ZS6SR/TimeBuddy/docs/photos/WhatsApp Image 2026-10-26 at 08.11.50.jpeg

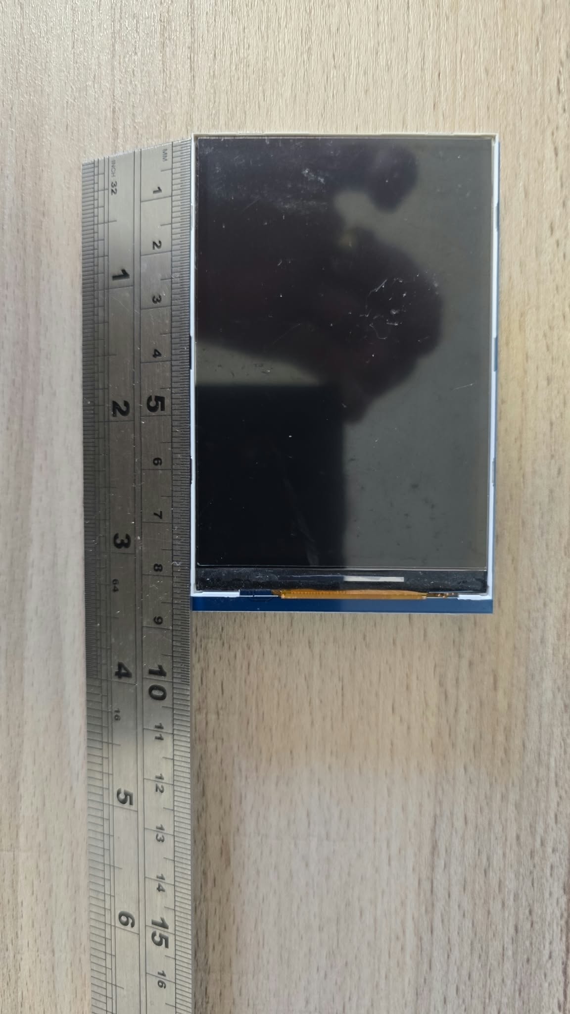
docs/photos/WhatsApp Image 2026-10-26 at 08.11.50.jpeg
