ZS6SR/TimeBuddy/case/timebuddy_stand.stl

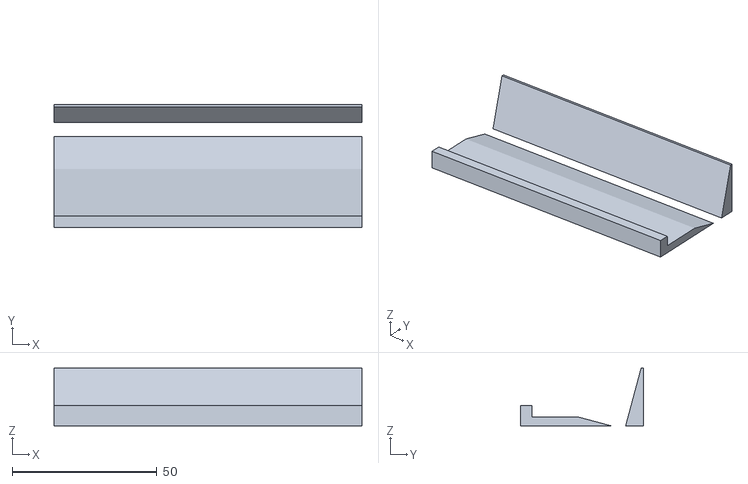
[picture p9: CAD file, 2026-10-26]
case/timebuddy_stand.stl
106.5 x 42.6 x 20.0
