ZS6SR/TimeBuddy/case/timebuddy_frame.stl

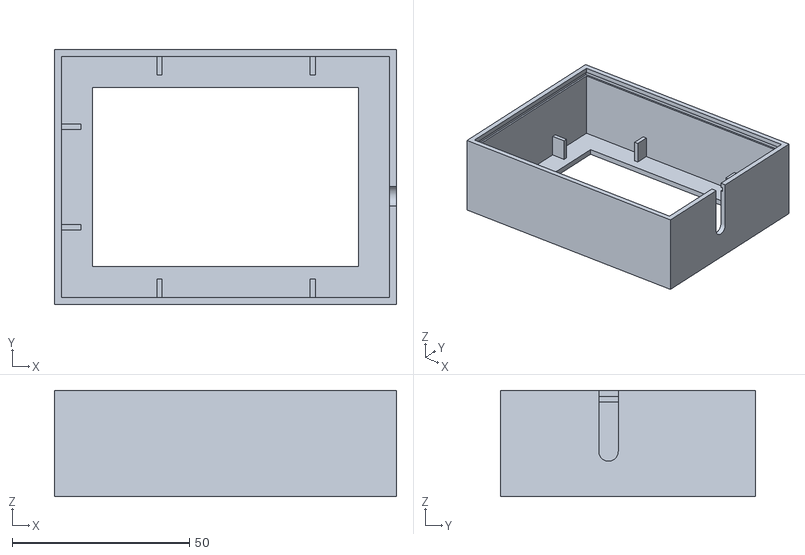
[picture p10: CAD file, 2026-10-26]
case/timebuddy_frame.stl
96.5 x 72.0 x 30.0
