ZS6SR/TimeBuddy/case/timebuddy_back.stl

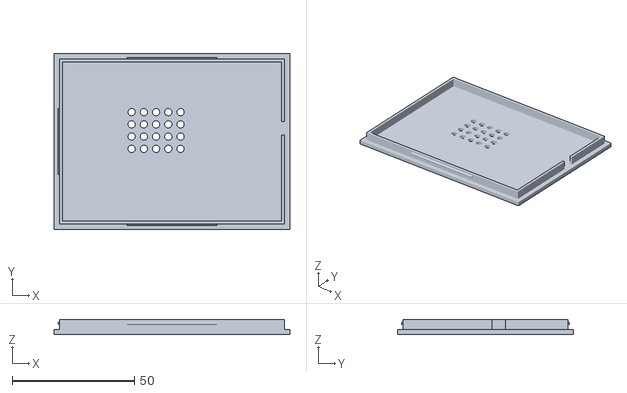
[picture p11: CAD file, 2026-10-26]
case/timebuddy_back.stl
96.5 x 72.0 x 6.00
