ZS6SR/TimeBuddy/firmware/src/main.cpp

#include <Arduino.h>
#include <ArduinoJson.h>
#include <Arduino_GFX_Library.h>
#include <DNSServer.h>
#include <ESPmDNS.h>
#include <HTTPClient.h>
#include <Preferences.h>
#include <WebServer.h>
#include <WiFi.h>
#include <WiFiClientSecure.h>
#include <Update.h>
#include <time.h>

#include "config.h"
#include "secrets.h"
#include "tracks.h"
#include "web.h"
#include "fonts/FreeSans9pt7b.h"
#include "fonts/FreeSans12pt7b.h"
#include "fonts/FreeSans16pt7b.h"
#include "fonts/FreeSansBoldOblique12pt7b.h"

static const int PAD = 14;

static const uint16_t COL_BG = RGB565(10, 14, 24);
static const uint16_t COL_TEXT = RGB565(235, 240, 248);
static const uint16_t COL_NAME = RGB565(120, 180, 255);
static const uint16_t COL_DIM = RGB565(140, 155, 180);
static const uint16_t COL_TEMP = RGB565(255, 190, 90);
static const uint16_t COL_LINE = RGB565(45, 55, 75);
static const uint16_t COL_BORDER = RGB565(70, 85, 110);
static const uint16_t COL_RACE = RGB565(230, 40, 40);
static const uint16_t COL_SUN = RGB565(255, 200, 40);
static const uint16_t COL_MOON = RGB565(220, 225, 240);
static const uint16_t COL_CLOUD = RGB565(200, 208, 220);
static const uint16_t COL_DARK_CLOUD = RGB565(120, 130, 150);
static const uint16_t COL_RAIN = RGB565(80, 160, 255);
static const uint16_t COL_SNOW = RGB565(255, 255, 255);

Arduino_DataBus *bus = new Arduino_SWPAR8(
    PIN_RS, GFX_NOT_DEFINED, PIN_WR, GFX_NOT_DEFINED,
    PIN_D0, PIN_D1, PIN_D2, PIN_D3, PIN_D4, PIN_D5, PIN_D6, PIN_D7);

#if DISPLAY_ST7796
Arduino_GFX *gfx = new Arduino_ST7796(bus, PIN_RST, PORTRAIT_ROTATION);
#else
Arduino_GFX *gfx = new Arduino_ILI9486(bus, PIN_RST, PORTRAIT_ROTATION);
#endif

Arduino_Canvas *canvas = nullptr;
Preferences prefs;
WebServer server(80);
DNSServer dns;

struct Layout {
  int title, date, icon, temp;
};
static const Layout PORTRAIT_LAYOUT = {50, 76, 110, 124};
static const Layout LANDSCAPE_LAYOUT = {38, 58, 76, 90};
static const int ROWS_PERCENT_LANDSCAPE = 40;

static bool landscape = false;
static int scrW, scrH, rowW, rowStep;
static const Layout *layout = &PORTRAIT_LAYOUT;

struct Weather {
  bool valid = false;
  float temp = 0;
  int code = -1;
  bool isDay = true;
};

enum Icon { ICON_NONE, ICON_CLEAR, ICON_PARTLY, ICON_CLOUDY, ICON_FOG, ICON_RAIN, ICON_SNOW, ICON_THUNDER };

static Weather weather[3];
struct Race {
  time_t weekendStart = 0;
  time_t start = 0;
  char place[48] = "";
  float lat = 0;
  float lon = 0;
  Weather forecast;
  const Track *track = nullptr;
};

static Race motogp;
static Race f1;

struct PaneType {
  const char *id;
  const char *title;
  const Race *race;
};

static const PaneType PANE_TYPES[] = {
    {"motogp", "MotoGP", &motogp},
    {"f1", "F1", &f1},
};
static const int PANE_TYPE_COUNT = sizeof(PANE_TYPES) / sizeof(PANE_TYPES[0]);

struct Place {
  char name[32];
  char country[32];
  char zone[48];
  char tz[64];
  float lat;
  float lon;
};

static Place places[3];
static int panes[2] = {0, 1};
static bool configChanged = false;

struct NetSettings {
  char ssid[33];
  char password[65];
  bool dhcp;
  char ip[16];
  char gateway[16];
  char subnet[16];
  char dns[16];
};

static NetSettings net;
static bool setupMode = false;
static unsigned long lastWebActivity = 0;
static unsigned long restartAt = 0;
static unsigned long lastMotoGPFetch = 0;
static unsigned long lastF1Fetch = 0;
static bool motogpFetched = false;
static bool f1Fetched = false;
static unsigned long lastWeatherFetch = 0;
static bool weatherEverFetched = false;
static int lastMinute = -1;
static bool lastButton = true;

static Icon iconFor(int code) {
  switch (code) {
    case 0: case 1: return ICON_CLEAR;
    case 2: return ICON_PARTLY;
    case 3: return ICON_CLOUDY;
    case 45: case 48: return ICON_FOG;
    case 51: case 53: case 55: case 56: case 57:
    case 61: case 63: case 65: case 66: case 67:
    case 80: case 81: case 82: return ICON_RAIN;
    case 71: case 73: case 75: case 77: case 85: case 86: return ICON_SNOW;
    case 95: case 96: case 99: return ICON_THUNDER;
    default: return ICON_NONE;
  }
}

static const float ICON_SCALE = 0.75f;
static Arduino_GFX *ink = nullptr;

static int sc(float v) {
  return lroundf(v * ICON_SCALE);
}

static void drawSun(int cx, int cy, float r) {
  for (int a = 0; a < 360; a += 45) {
    float rad = a * DEG_TO_RAD;
    int x0 = cx + cosf(rad) * sc(r + 4), y0 = cy + sinf(rad) * sc(r + 4);
    int x1 = cx + cosf(rad) * sc(r + 8), y1 = cy + sinf(rad) * sc(r + 8);
    ink->drawLine(x0, y0, x1, y1, COL_SUN);
    ink->drawLine(x0 + 1, y0, x1 + 1, y1, COL_SUN);
  }
  ink->fillCircle(cx, cy, sc(r), COL_SUN);
}

static void drawMoon(int cx, int cy, float r) {
  ink->fillCircle(cx, cy, sc(r), COL_MOON);
  ink->fillCircle(cx + sc(r / 2 + 2), cy - sc(r / 3), sc(r - 1), COL_BG);
}

static void drawCloud(int cx, int cy, uint16_t colour) {
  ink->fillCircle(cx - sc(10), cy + sc(2), sc(8), colour);
  ink->fillCircle(cx + sc(1), cy - sc(5), sc(11), colour);
  ink->fillCircle(cx + sc(11), cy + sc(2), sc(8), colour);
  ink->fillRoundRect(cx - sc(18), cy + sc(1), sc(37), sc(10), sc(5), colour);
}

static void drawIcon(Icon icon, bool isDay, int cx, int cy) {
  switch (icon) {
    case ICON_CLEAR:
      if (isDay) drawSun(cx, cy, 10);
      else drawMoon(cx, cy, 13);
      break;
    case ICON_PARTLY:
      if (isDay) drawSun(cx + sc(8), cy - sc(8), 8);
      else drawMoon(cx + sc(8), cy - sc(8), 10);
      drawCloud(cx - sc(3), cy + sc(5), COL_CLOUD);
      break;
    case ICON_CLOUDY:
      drawCloud(cx, cy, COL_CLOUD);
      break;
    case ICON_FOG:
      for (int i = 0; i < 4; i++) {
        int w = sc((i % 2) ? 30 : 38);
        ink->fillRoundRect(cx - w / 2, cy - sc(12) + i * sc(8), w, sc(4), sc(2), COL_CLOUD);
      }
      break;
    case ICON_RAIN:
      drawCloud(cx, cy - sc(6), COL_CLOUD);
      for (int i = -1; i <= 1; i++) {
        int x = cx + i * sc(10);
        ink->drawLine(x + sc(2), cy + sc(9), x - sc(2), cy + sc(17), COL_RAIN);
        ink->drawLine(x + sc(2) + 1, cy + sc(9), x - sc(2) + 1, cy + sc(17), COL_RAIN);
      }
      break;
    case ICON_SNOW:
      drawCloud(cx, cy - sc(6), COL_CLOUD);
      for (int i = -1; i <= 1; i++) {
        int x = cx + i * sc(10);
        ink->fillCircle(x, cy + sc(12), 2, COL_SNOW);
        ink->fillCircle(x + sc(5), cy + sc(18), 2, COL_SNOW);
      }
      break;
    case ICON_THUNDER:
      drawCloud(cx, cy - sc(6), COL_DARK_CLOUD);
      ink->fillTriangle(cx + sc(2), cy + sc(4), cx - sc(6), cy + sc(14), cx + sc(1), cy + sc(14), COL_SUN);
      ink->fillTriangle(cx - sc(1), cy + sc(12), cx + sc(6), cy + sc(12), cx - sc(3), cy + sc(22), COL_SUN);
      break;
    default:
      break;
  }
}

static void printAt(const GFXfont *font, const char *text, int x, int y, uint16_t colour, bool alignRight) {
  int16_t x1, y1;
  uint16_t w, h;
  canvas->setFont(font);
  canvas->setTextColor(colour);
  canvas->getTextBounds(text, 0, y, &x1, &y1, &w, &h);
  canvas->setCursor(alignRight ? x - (int)w - x1 : x - x1, y);
  canvas->print(text);
}

static void drawWeather(Arduino_GFX *g, const Weather &w, int x, int iconY, int tempY) {
  ink = g;
  drawIcon(iconFor(w.code), w.isDay, x + 16, iconY);

  char buf[16];
  snprintf(buf, sizeof(buf), "%d", (int)lroundf(w.temp));
  int16_t x1, y1;
  uint16_t tw, th;
  int tx = x + 38;
  g->setFont(&FreeSans12pt7b);
  g->getTextBounds(buf, 0, tempY, &x1, &y1, &tw, &th);
  g->setTextColor(COL_TEMP);
  g->setCursor(tx - x1, tempY);
  g->print(buf);
  int dx = tx + tw + 5;
  g->drawCircle(dx, y1 + 3, 2, COL_TEMP);
  g->setFont(&FreeSans9pt7b);
  g->setCursor(dx + 4, y1 + 13);
  g->print("C");
}

static void showStatus(const char *line1, const char *line2, const char *line3 = nullptr) {
  gfx->fillScreen(COL_BG);
  gfx->setFont(&FreeSans12pt7b);
  gfx->setTextColor(COL_TEXT);
  gfx->setCursor(30, 140);
  gfx->print(line1);
  gfx->setFont(&FreeSans9pt7b);
  gfx->setTextColor(COL_DIM);
  gfx->setCursor(30, 175);
  gfx->print(line2);
  if (line3) {
    gfx->setCursor(30, 200);
    gfx->print(line3);
  }
}

static void localTimeFor(const Place &loc, time_t now, struct tm *out);

static void raceWhen(const Race &race, char *when, size_t size) {
  snprintf(when, size, "--");
  if (race.start) {
    const Place &loc = places[RACE_TIME_LOCATION];
    struct tm from, to;
    localTimeFor(loc, race.weekendStart ? race.weekendStart : race.start, &from);
    localTimeFor(loc, race.start, &to);
    char a[16], b[24];
    strftime(a, sizeof(a), from.tm_mon == to.tm_mon ? "%d" : "%d %b", &from);
    strftime(b, sizeof(b), "%d %b %H:%M", &to);
    snprintf(when, size, "%s - %s", a, b);
  }
}

static void drawBlock(int x, int y, int w, int h, const PaneType &type) {
  const Race &race = *type.race;
  gfx->drawRoundRect(x, y, w, h, 6, COL_BORDER);
  gfx->setFont(&FreeSansBoldOblique12pt7b);
  gfx->setTextColor(COL_RACE);
  gfx->setCursor(x + 10, y + 26);
  gfx->print(type.title);
  if (race.track) {
    gfx->drawBitmap(x + w - 10 - TRACK_W, y + 8, race.track->bits, TRACK_W, TRACK_H, COL_TEXT);
  }

  char when[48];
  raceWhen(race, when, sizeof(when));
  if (race.forecast.valid) {
    drawWeather(gfx, race.forecast, x + 10, y + h - 74, y + h - 64);
  }
  gfx->setFont(&FreeSans12pt7b);
  gfx->setTextColor(COL_TEXT);
  gfx->setCursor(x + 10, y + h - 36);
  gfx->print(race.place);
  gfx->setFont(&FreeSans9pt7b);
  gfx->setTextColor(COL_DIM);
  gfx->setCursor(x + 10, y + h - 14);
  gfx->print(when);
}

static void drawPane() {
  if (rowW < scrW) {
    const int gap = 8;
    int x = rowW + gap;
    int w = scrW - x - gap;
    int h = (scrH - 3 * gap) / 2;
    gfx->fillRect(rowW, 0, scrW - rowW, scrH, COL_BG);
    drawBlock(x, gap, w, h, PANE_TYPES[panes[0]]);
    drawBlock(x, 2 * gap + h, w, h, PANE_TYPES[panes[1]]);
  }
}

static void applyOrientation() {
  gfx->setRotation(landscape ? LANDSCAPE_ROTATION : PORTRAIT_ROTATION);
  scrW = gfx->width();
  scrH = gfx->height();
  rowW = landscape ? scrW * ROWS_PERCENT_LANDSCAPE / 100 : scrW;
  rowStep = scrH / 3;
  layout = landscape ? &LANDSCAPE_LAYOUT : &PORTRAIT_LAYOUT;

  delete canvas;
  canvas = new Arduino_Canvas(rowW, scrH - 2 * rowStep, gfx);
  canvas->begin(GFX_SKIP_OUTPUT_BEGIN);
  gfx->fillScreen(COL_BG);
  drawPane();
}

static void localTimeFor(const Place &loc, time_t now, struct tm *out) {
  setenv("TZ", loc.tz, 1);
  tzset();
  localtime_r(&now, out);
}

static void drawRow(int i, time_t now) {
  const Place &loc = places[i];
  struct tm t;
  localTimeFor(loc, now, &t);

  canvas->fillScreen(COL_BG);
  if (i > 0) {
    canvas->drawFastHLine(PAD, 0, rowW - 2 * PAD, COL_LINE);
  }

  printAt(&FreeSans12pt7b, loc.name, PAD, layout->title, COL_NAME, false);

  char buf[32];
  strftime(buf, sizeof(buf), "%H:%M", &t);
  printAt(&FreeSans16pt7b, buf, rowW - PAD, layout->title, COL_TEXT, true);
  strftime(buf, sizeof(buf), "%a %d %b", &t);
  printAt(&FreeSans9pt7b, buf, rowW - PAD, layout->date, COL_DIM, true);

  const Weather &w = weather[i];
  if (w.valid) {
    drawWeather(canvas, w, PAD, layout->icon, layout->temp);
  } else {
    printAt(&FreeSans12pt7b, "--", PAD, layout->temp, COL_DIM, false);
  }

  int y = i * rowStep;
  int h = (i == 2) ? scrH - y : rowStep;
  gfx->draw16bitRGBBitmap(0, y, canvas->getFramebuffer(), rowW, h);
}

static void drawAll() {
  time_t now = time(nullptr);
  for (int i = 0; i < 3; i++) {
    drawRow(i, now);
  }
}

static bool fetchWeather() {
  String url = "https://api.open-meteo.com/v1/forecast?current=temperature_2m,weather_code,is_day&latitude=";
  for (int i = 0; i < 3; i++) {
    if (i) url += ",";
    url += String(places[i].lat, 4);
  }
  url += "&longitude=";
  for (int i = 0; i < 3; i++) {
    if (i) url += ",";
    url += String(places[i].lon, 4);
  }

  WiFiClientSecure client;
  client.setInsecure();
  HTTPClient http;
  http.setTimeout(10000);
  http.useHTTP10(true);
  if (!http.begin(client, url)) {
    Serial.println("Weather begin failed");
    return false;
  }
  int status = http.GET();
  if (status != HTTP_CODE_OK) {
    Serial.printf("Weather HTTP %d\n", status);
    http.end();
    return false;
  }

  JsonDocument filter;
  filter[0]["current"]["temperature_2m"] = true;
  filter[0]["current"]["weather_code"] = true;
  filter[0]["current"]["is_day"] = true;
  JsonDocument doc;
  DeserializationError err = deserializeJson(doc, http.getStream(), DeserializationOption::Filter(filter));
  http.end();
  if (err) {
    Serial.printf("Weather JSON: %s\n", err.c_str());
    return false;
  }

  JsonArray arr = doc.as<JsonArray>();
  for (int i = 0; i < 3 && i < (int)arr.size(); i++) {
    JsonObject cur = arr[i]["current"];
    if (cur["temperature_2m"].is<float>()) {
      weather[i].temp = cur["temperature_2m"].as<float>();
      weather[i].code = cur["weather_code"] | -1;
      weather[i].isDay = (cur["is_day"] | 1) == 1;
      weather[i].valid = true;
    }
  }
  return true;
}

class BlockingStream : public Stream {
 public:
  BlockingStream(WiFiClientSecure &client, unsigned long timeout) : client_(client), timeout_(timeout) {}
  int available() override { return client_.available(); }
  int read() override { return wait() ? client_.read() : -1; }
  int peek() override { return wait() ? client_.peek() : -1; }
  size_t write(uint8_t) override { return 0; }

 private:
  bool wait() {
    unsigned long start = millis();
    while (!client_.available()) {
      if (!client_.connected() || millis() - start > timeout_) return false;
      delay(1);
    }
    return true;
  }
  WiFiClientSecure &client_;
  unsigned long timeout_;
};

static int64_t daysFromCivil(int y, int m, int d) {
  y -= m <= 2;
  int era = (y >= 0 ? y : y - 399) / 400;
  int yoe = y - era * 400;
  int doy = (153 * (m + (m > 2 ? -3 : 9)) + 2) / 5 + d - 1;
  int doe = yoe * 365 + yoe / 4 - yoe / 100 + doy;
  return (int64_t)era * 146097 + doe - 719468;
}

static time_t parseIso(const char *s) {
  int Y, M, D, h, mi, sec;
  int n = 0;
  if (sscanf(s, "%d-%d-%dT%d:%d:%d%n", &Y, &M, &D, &h, &mi, &sec, &n) < 6) return 0;
  const char *tz = s + n;
  long offset = 0;
  if (*tz == '+' || *tz == '-') {
    int sign = (*tz == '-') ? -1 : 1;
    int digits[4] = {0, 0, 0, 0};
    int k = 0;
    for (const char *c = tz + 1; *c && k < 4; c++) {
      if (isdigit((unsigned char)*c)) digits[k++] = *c - '0';
    }
    offset = sign * ((digits[0] * 10 + digits[1]) * 3600L + (digits[2] * 10 + digits[3]) * 60L);
  }
  return (time_t)(daysFromCivil(Y, M, D) * 86400 + h * 3600L + mi * 60L + sec - offset);
}

static bool fetchF1(Race &out) {
  WiFiClientSecure client;
  client.setInsecure();
  HTTPClient http;
  http.setTimeout(10000);
  http.useHTTP10(true);
  if (!http.begin(client, "https://api.jolpi.ca/ergast/f1/current/next.json")) return false;
  int status = http.GET();
  if (status != HTTP_CODE_OK) {
    Serial.printf("F1 HTTP %d\n", status);
    http.end();
    return false;
  }
  JsonDocument filter;
  JsonObject f = filter["MRData"]["RaceTable"]["Races"][0].to<JsonObject>();
  f["date"] = true;
  f["time"] = true;
  f["FirstPractice"]["date"] = true;
  f["FirstPractice"]["time"] = true;
  f["Circuit"]["Location"]["locality"] = true;
  f["Circuit"]["Location"]["country"] = true;
  f["Circuit"]["Location"]["lat"] = true;
  f["Circuit"]["Location"]["long"] = true;
  JsonDocument doc;
  BlockingStream stream(client, 10000);
  DeserializationError err = deserializeJson(doc, stream, DeserializationOption::Filter(filter));
  http.end();
  if (err) {
    Serial.printf("F1 JSON: %s\n", err.c_str());
    return false;
  }
  JsonObject race = doc["MRData"]["RaceTable"]["Races"][0];
  if (race.isNull()) return false;
  String iso = String(race["date"] | "") + "T" + (race["time"] | "00:00:00Z");
  out.start = parseIso(iso.c_str());
  iso = String(race["FirstPractice"]["date"] | "") + "T" + (race["FirstPractice"]["time"] | "00:00:00Z");
  out.weekendStart = parseIso(iso.c_str());
  snprintf(out.place, sizeof(out.place), "%s, %s", (const char *)(race["Circuit"]["Location"]["locality"] | ""),
           (const char *)(race["Circuit"]["Location"]["country"] | ""));
  out.lat = atof(race["Circuit"]["Location"]["lat"] | "0");
  out.lon = atof(race["Circuit"]["Location"]["long"] | "0");
  return out.start != 0;
}

static bool fetchMotoGP(int year, Race &out) {
  WiFiClientSecure client;
  client.setInsecure();
  HTTPClient http;
  http.setTimeout(15000);
  http.useHTTP10(true);
  String url = String("https://api.motogp.pulselive.com/motogp/v1/events?seasonYear=") + year;
  if (!http.begin(client, url)) return false;
  int status = http.GET();
  if (status != HTTP_CODE_OK) {
    Serial.printf("MotoGP HTTP %d\n", status);
    http.end();
    return false;
  }
  JsonDocument filter;
  filter["date_start"] = true;
  filter["circuit"]["city"] = true;
  filter["circuit"]["country"] = true;
  filter["circuit"]["lat"] = true;
  filter["circuit"]["lng"] = true;
  filter["broadcasts"][0]["shortname"] = true;
  filter["broadcasts"][0]["category"]["acronym"] = true;
  filter["broadcasts"][0]["date_start"] = true;

  BlockingStream stream(client, 15000);
  time_t now = time(nullptr);
  bool found = false;
  bool more = stream.find("[");
  while (more) {
    JsonDocument doc;
    DeserializationError err = deserializeJson(doc, stream, DeserializationOption::Filter(filter));
    if (err) {
      Serial.printf("MotoGP JSON: %s\n", err.c_str());
      break;
    }
    for (JsonObject b : doc["broadcasts"].as<JsonArray>()) {
      if (strcmp(b["shortname"] | "", "RAC") == 0 && strcmp(b["category"]["acronym"] | "", "MGP") == 0) {
        time_t t = parseIso(b["date_start"] | "");
        if (t > now && (!found || t < out.start)) {
          found = true;
          out.start = t;
          out.weekendStart = parseIso(doc["date_start"] | "");
          snprintf(out.place, sizeof(out.place), "%s, %s", (const char *)(doc["circuit"]["city"] | ""),
                   (const char *)(doc["circuit"]["country"] | ""));
          out.lat = atof(doc["circuit"]["lat"] | "0");
          out.lon = atof(doc["circuit"]["lng"] | "0");
        }
      }
    }
    more = stream.findUntil(",", "]");
  }
  http.end();
  return found;
}

static const Track *findTrack(float lat, float lon) {
  const Track *best = nullptr;
  float bestKm = 30;
  for (const Track &t : TRACKS) {
    float dx = (t.lon - lon) * cosf(lat * DEG_TO_RAD) * 111.32f;
    float dy = (t.lat - lat) * 110.57f;
    float km = sqrtf(dx * dx + dy * dy);
    if (km < bestKm) {
      bestKm = km;
      best = &t;
    }
  }
  return best;
}

static void fetchRaceForecast(Race &race) {
  race.forecast.valid = false;
  if (!race.start || race.start - time(nullptr) > 15L * 24 * 3600) return;
  struct tm t;
  gmtime_r(&race.start, &t);
  char hour[20];
  strftime(hour, sizeof(hour), "%Y-%m-%dT%H:00", &t);
  String url = "https://api.open-meteo.com/v1/forecast?hourly=temperature_2m,weather_code,is_day";
  url += "&latitude=" + String(race.lat, 4) + "&longitude=" + String(race.lon, 4);
  url += String("&start_hour=") + hour + "&end_hour=" + hour;

  WiFiClientSecure client;
  client.setInsecure();
  HTTPClient http;
  http.setTimeout(10000);
  http.useHTTP10(true);
  if (!http.begin(client, url)) return;
  int status = http.GET();
  if (status != HTTP_CODE_OK) {
    http.end();
    return;
  }
  JsonDocument doc;
  BlockingStream stream(client, 10000);
  DeserializationError err = deserializeJson(doc, stream);
  http.end();
  if (err || !doc["hourly"]["temperature_2m"][0].is<float>()) return;
  race.forecast.temp = doc["hourly"]["temperature_2m"][0];
  race.forecast.code = doc["hourly"]["weather_code"][0] | -1;
  race.forecast.isDay = (doc["hourly"]["is_day"][0] | 1) == 1;
  race.forecast.valid = true;
}

static bool fetchMotoGPRace() {
  time_t now = time(nullptr);
  struct tm t;
  gmtime_r(&now, &t);
  for (int attempt = 0; attempt < 2; attempt++) {
    Race r;
    if (fetchMotoGP(t.tm_year + 1900, r) || fetchMotoGP(t.tm_year + 1901, r)) {
      fetchRaceForecast(r);
      r.track = findTrack(r.lat, r.lon);
      motogp = r;
      return true;
    }
  }
  return false;
}

static bool fetchF1Race() {
  for (int attempt = 0; attempt < 2; attempt++) {
    Race r;
    if (fetchF1(r)) {
      fetchRaceForecast(r);
      r.track = findTrack(r.lat, r.lon);
      f1 = r;
      return true;
    }
  }
  return false;
}

static void loadDefaults() {
  for (int i = 0; i < 3; i++) {
    Place &p = places[i];
    strlcpy(p.name, LOCATIONS[i].name, sizeof(p.name));
    strlcpy(p.country, LOCATIONS[i].country, sizeof(p.country));
    p.zone[0] = '\0';
    strlcpy(p.tz, LOCATIONS[i].posixTz, sizeof(p.tz));
    p.lat = LOCATIONS[i].lat;
    p.lon = LOCATIONS[i].lon;
  }
  panes[0] = 0;
  panes[1] = 1;
}

static int paneIndex(const char *id) {
  for (int i = 0; i < PANE_TYPE_COUNT; i++) {
    if (strcmp(PANE_TYPES[i].id, id) == 0) return i;
  }
  return -1;
}

static bool applyConfig(JsonObjectConst cfg) {
  JsonArrayConst locs = cfg["locations"];
  JsonArrayConst ids = cfg["panes"];
  if (locs.size() != 3 || ids.size() != 2) return false;

  Place next[3];
  for (int i = 0; i < 3; i++) {
    JsonObjectConst l = locs[i];
    const char *tz = l["tz"] | "";
    if (!*tz || !l["lat"].is<float>() || !l["lon"].is<float>()) return false;
    strlcpy(next[i].name, l["name"] | "", sizeof(next[i].name));
    strlcpy(next[i].country, l["country"] | "", sizeof(next[i].country));
    strlcpy(next[i].zone, l["zone"] | "", sizeof(next[i].zone));
    strlcpy(next[i].tz, tz, sizeof(next[i].tz));
    next[i].lat = l["lat"];
    next[i].lon = l["lon"];
  }
  int nextPanes[2];
  for (int i = 0; i < 2; i++) {
    nextPanes[i] = paneIndex(ids[i] | "");
    if (nextPanes[i] < 0) return false;
  }

  memcpy(places, next, sizeof(places));
  memcpy(panes, nextPanes, sizeof(panes));
  return true;
}

static void configToJson(JsonObject cfg) {
  JsonArray locs = cfg["locations"].to<JsonArray>();
  for (const Place &p : places) {
    JsonObject l = locs.add<JsonObject>();
    l["name"] = p.name;
    l["country"] = p.country;
    l["zone"] = p.zone;
    l["tz"] = p.tz;
    l["lat"] = p.lat;
    l["lon"] = p.lon;
  }
  JsonArray ids = cfg["panes"].to<JsonArray>();
  for (int p : panes) {
    ids.add(PANE_TYPES[p].id);
  }
}

static void loadConfig() {
  loadDefaults();
  if (!prefs.isKey("config")) return;
  String saved = prefs.getString("config", "");
  JsonDocument doc;
  if (deserializeJson(doc, saved) || !applyConfig(doc.as<JsonObjectConst>())) {
    Serial.println("Saved config invalid, using defaults");
    loadDefaults();
  }
}

static void saveConfig() {
  JsonDocument doc;
  configToJson(doc.to<JsonObject>());
  String out;
  serializeJson(doc, out);
  prefs.putString("config", out);
}

static void loadNetwork() {
  strlcpy(net.ssid, WIFI_SSID, sizeof(net.ssid));
  strlcpy(net.password, WIFI_PASSWORD, sizeof(net.password));
  net.dhcp = true;
  net.ip[0] = net.gateway[0] = net.subnet[0] = net.dns[0] = '\0';

  if (!prefs.isKey("network")) return;
  String saved = prefs.getString("network", "");
  JsonDocument doc;
  if (deserializeJson(doc, saved)) return;
  strlcpy(net.ssid, doc["ssid"] | net.ssid, sizeof(net.ssid));
  strlcpy(net.password, doc["password"] | net.password, sizeof(net.password));
  net.dhcp = doc["dhcp"] | true;
  strlcpy(net.ip, doc["ip"] | "", sizeof(net.ip));
  strlcpy(net.gateway, doc["gateway"] | "", sizeof(net.gateway));
  strlcpy(net.subnet, doc["subnet"] | "", sizeof(net.subnet));
  strlcpy(net.dns, doc["dns"] | "", sizeof(net.dns));
}

static void saveNetwork() {
  JsonDocument doc;
  doc["ssid"] = net.ssid;
  doc["password"] = net.password;
  doc["dhcp"] = net.dhcp;
  doc["ip"] = net.ip;
  doc["gateway"] = net.gateway;
  doc["subnet"] = net.subnet;
  doc["dns"] = net.dns;
  String out;
  serializeJson(doc, out);
  prefs.putString("network", out);
}

static bool validIp(const char *s) {
  IPAddress ip;
  return ip.fromString(s);
}

static bool applyNetwork(JsonObjectConst n) {
  NetSettings next = net;
  const char *ssid = n["ssid"] | "";
  if (!*ssid || strlen(ssid) >= sizeof(next.ssid)) return false;
  strlcpy(next.ssid, ssid, sizeof(next.ssid));
  const char *password = n["password"] | "";
  if (strlen(password) >= sizeof(next.password)) return false;
  if (*password || n["clearPassword"] == true) {
    strlcpy(next.password, password, sizeof(next.password));
  }
  next.dhcp = n["dhcp"] | true;
  strlcpy(next.ip, n["ip"] | "", sizeof(next.ip));
  strlcpy(next.gateway, n["gateway"] | "", sizeof(next.gateway));
  strlcpy(next.subnet, n["subnet"] | "", sizeof(next.subnet));
  strlcpy(next.dns, n["dns"] | "", sizeof(next.dns));
  if (!next.dhcp) {
    if (!validIp(next.ip) || !validIp(next.gateway) || !validIp(next.subnet)) return false;
    if (*next.dns && !validIp(next.dns)) return false;
  }
  net = next;
  return true;
}

static void weatherToJson(JsonObject out, const Weather &w) {
  out["temp"] = w.temp;
  out["code"] = w.code;
  out["isDay"] = w.isDay;
}

static void sendGzip(const char *type, const uint8_t *data, size_t len) {
  server.sendHeader("Content-Encoding", "gzip");
  server.sendHeader("Cache-Control", "no-cache");
  server.send_P(200, type, (PGM_P)data, len);
}

static void handleState() {
  lastWebActivity = millis();
  JsonDocument doc;
  doc["landscape"] = landscape;
  doc["setupMode"] = setupMode;
  doc["setupSsid"] = SETUP_AP_SSID;
  doc["firmware"] = __DATE__ " " __TIME__;
  JsonObject n = doc["network"].to<JsonObject>();
  n["ssid"] = net.ssid;
  n["hasPassword"] = net.password[0] != '\0';
  n["dhcp"] = net.dhcp;
  n["ip"] = net.ip;
  n["gateway"] = net.gateway;
  n["subnet"] = net.subnet;
  n["dns"] = net.dns;
  n["address"] = (setupMode ? WiFi.softAPIP() : WiFi.localIP()).toString();
  JsonObject current = n["current"].to<JsonObject>();
  current["ip"] = WiFi.localIP().toString();
  current["gateway"] = WiFi.gatewayIP().toString();
  current["subnet"] = WiFi.subnetMask().toString();
  current["dns"] = WiFi.dnsIP().toString();
  configToJson(doc["config"].to<JsonObject>());

  JsonArray types = doc["paneTypes"].to<JsonArray>();
  for (const PaneType &t : PANE_TYPES) {
    JsonObject o = types.add<JsonObject>();
    o["id"] = t.id;
    o["title"] = t.title;
  }

  time_t now = time(nullptr);
  JsonArray clocks = doc["clocks"].to<JsonArray>();
  for (int i = 0; i < 3; i++) {
    struct tm t;
    localTimeFor(places[i], now, &t);
    char buf[32];
    JsonObject c = clocks.add<JsonObject>();
    strftime(buf, sizeof(buf), "%H:%M", &t);
    c["time"] = buf;
    strftime(buf, sizeof(buf), "%a %d %b", &t);
    c["date"] = buf;
    if (weather[i].valid) weatherToJson(c["weather"].to<JsonObject>(), weather[i]);
  }

  static const char HEX_DIGITS[] = "0123456789abcdef";
  JsonObject blocks = doc["paneData"].to<JsonObject>();
  for (const PaneType &type : PANE_TYPES) {
    const Race &race = *type.race;
    JsonObject b = blocks[type.id].to<JsonObject>();
    b["title"] = type.title;
    b["place"] = race.place;
    char when[48];
    raceWhen(race, when, sizeof(when));
    b["when"] = when;
    if (race.forecast.valid) weatherToJson(b["forecast"].to<JsonObject>(), race.forecast);
    if (race.track) {
      const size_t len = (TRACK_W + 7) / 8 * TRACK_H;
      String hex;
      hex.reserve(len * 2);
      for (size_t k = 0; k < len; k++) {
        uint8_t v = pgm_read_byte(&race.track->bits[k]);
        hex += HEX_DIGITS[v >> 4];
        hex += HEX_DIGITS[v & 15];
      }
      b["track"] = hex;
    }
  }

  String out;
  serializeJson(doc, out);
  server.send(200, "application/json", out);
}

static void handleSaveConfig() {
  JsonDocument doc;
  if (deserializeJson(doc, server.arg("plain")) || !applyConfig(doc.as<JsonObjectConst>())) {
    server.send(400, "application/json", "{\"error\":\"invalid config\"}");
    return;
  }
  saveConfig();
  configChanged = true;
  server.send(200, "application/json", "{}");
}

static void handleSaveNetwork() {
  lastWebActivity = millis();
  JsonDocument doc;
  if (deserializeJson(doc, server.arg("plain")) || !applyNetwork(doc.as<JsonObjectConst>())) {
    server.send(400, "application/json", "{\"error\":\"invalid network settings\"}");
    return;
  }
  saveNetwork();
  server.send(200, "application/json", "{}");
  restartAt = millis() + 1500;
}

static void handleUpdateDone() {
  lastWebActivity = millis();
  if (Update.hasError() || !Update.isFinished()) {
    String error = Update.hasError() ? Update.errorString() : "No firmware received";
    server.send(500, "application/json", "{\"error\":\"" + error + "\"}");
    showStatus("Update failed", error.c_str());
    restartAt = millis() + 5000;
    return;
  }
  server.send(200, "application/json", "{}");
  showStatus("Update complete", "Restarting...");
  restartAt = millis() + 1000;
}

static void handleUpdateUpload() {
  HTTPUpload &upload = server.upload();
  switch (upload.status) {
    case UPLOAD_FILE_START:
      Serial.printf("Update: %s\n", upload.filename.c_str());
      showStatus("Updating firmware", "Don't unplug TimeBuddy");
      Update.begin(UPDATE_SIZE_UNKNOWN);
      break;
    case UPLOAD_FILE_WRITE:
      if (Update.isRunning()) Update.write(upload.buf, upload.currentSize);
      break;
    case UPLOAD_FILE_END:
      if (Update.isRunning()) Update.end(true);
      break;
    case UPLOAD_FILE_ABORTED:
      Update.abort();
      break;
  }
}

static void startWebServer() {
  server.on("/", HTTP_GET, [] { sendGzip("text/html", WEB_INDEX, WEB_INDEX_LEN); });
  server.on("/zones.json", HTTP_GET, [] { sendGzip("application/json", WEB_ZONES, WEB_ZONES_LEN); });
  server.on("/api/state", HTTP_GET, handleState);
  server.on("/api/config", HTTP_POST, handleSaveConfig);
  server.on("/api/network", HTTP_POST, handleSaveNetwork);
  server.on("/update", HTTP_POST, handleUpdateDone, handleUpdateUpload);
  server.onNotFound([] {
    if (setupMode) {
      server.sendHeader("Location", "http://" + WiFi.softAPIP().toString() + "/");
      server.send(302, "text/plain", "");
    } else {
      server.send(404, "text/plain", "Not found");
    }
  });
  server.begin();
  if (MDNS.begin(WEB_HOSTNAME)) {
    MDNS.addService("http", "tcp", 80);
  }
}

static void connectWiFi(unsigned long timeoutMs = 20000) {
  if (WiFi.status() == WL_CONNECTED) return;
  WiFi.mode(WIFI_STA);
  if (!net.dhcp) {
    IPAddress ip, gateway, subnet, dnsIp;
    ip.fromString(net.ip);
    gateway.fromString(net.gateway);
    subnet.fromString(net.subnet);
    if (!dnsIp.fromString(net.dns)) dnsIp = gateway;
    WiFi.config(ip, gateway, subnet, dnsIp);
  }
  WiFi.begin(net.ssid, net.password);
  WiFi.setTxPower(WIFI_POWER_8_5dBm);
  unsigned long start = millis();
  while (WiFi.status() != WL_CONNECTED && millis() - start < timeoutMs) {
    delay(250);
  }
}

static void startSetupMode() {
  setupMode = true;
  WiFi.disconnect(true);
  WiFi.mode(WIFI_AP);
  WiFi.softAP(SETUP_AP_SSID);
  dns.start(53, "*", WiFi.softAPIP());
  startWebServer();
  lastWebActivity = millis();
  String address = "then open http://" + WiFi.softAPIP().toString();
  Serial.println("Setup mode: " SETUP_AP_SSID);
  showStatus("Wi-Fi setup", "Join Wi-Fi network " SETUP_AP_SSID, address.c_str());
}

void setup() {
  Serial.begin(115200);
  pinMode(PIN_BUTTON, INPUT_PULLUP);
  prefs.begin("timebuddy");
  landscape = prefs.getBool("landscape", false);
  loadConfig();
  loadNetwork();

  if (!gfx->begin()) {
    Serial.println("Display init failed");
  }
  gfx->invertDisplay(DISPLAY_INVERT);
  applyOrientation();

  showStatus("TimeBuddy", (String("Connecting to ") + net.ssid + "...").c_str());
  connectWiFi(WIFI_CONNECT_TIMEOUT_MS);
  if (WiFi.status() != WL_CONNECTED) {
    startSetupMode();
    return;
  }

  startWebServer();
  String address = "http://" + WiFi.localIP().toString();
  Serial.println(address);
  showStatus("Syncing time...", address.c_str());
  configTime(0, 0, "pool.ntp.org", "time.google.com");
  while (time(nullptr) < 1700000000) {
    delay(250);
  }
  delay(3000);
  gfx->fillScreen(COL_BG);
  drawPane();
}

void loop() {
  if (restartAt && (long)(millis() - restartAt) >= 0) {
    ESP.restart();
  }
  if (setupMode) {
    dns.processNextRequest();
    server.handleClient();
    if (millis() - lastWebActivity >= SETUP_MODE_TIMEOUT_MS) {
      ESP.restart();
    }
    delay(5);
    return;
  }

  if (WiFi.status() != WL_CONNECTED) {
    connectWiFi();
  }
  server.handleClient();

  bool redraw = false;
  if (configChanged) {
    configChanged = false;
    for (Weather &w : weather) {
      w.valid = false;
    }
    lastWeatherFetch = 0;
    drawPane();
    redraw = true;
  }
  unsigned long interval = weatherEverFetched ? WEATHER_REFRESH_MS : WEATHER_RETRY_MS;
  if (lastWeatherFetch == 0 || millis() - lastWeatherFetch >= interval) {
    lastWeatherFetch = millis();
    if (WiFi.status() == WL_CONNECTED && fetchWeather()) {
      weatherEverFetched = true;
      redraw = true;
    }
  }

  if (WiFi.status() == WL_CONNECTED) {
    bool paneChanged = false;
    if (lastMotoGPFetch == 0 || millis() - lastMotoGPFetch >= (motogpFetched ? RACE_REFRESH_MS : RACE_RETRY_MS)) {
      lastMotoGPFetch = millis();
      motogpFetched = fetchMotoGPRace();
      paneChanged = true;
    }
    if (lastF1Fetch == 0 || millis() - lastF1Fetch >= (f1Fetched ? RACE_REFRESH_MS : RACE_RETRY_MS)) {
      lastF1Fetch = millis();
      f1Fetched = fetchF1Race();
      paneChanged = true;
    }
    if (paneChanged) {
      drawPane();
    }
  }

  time_t now = time(nullptr);
  int minute = (now / 60) % 60;
  if (minute != lastMinute) {
    lastMinute = minute;
    redraw = true;
  }

  bool button = digitalRead(PIN_BUTTON);
  if (!button && lastButton) {
    landscape = !landscape;
    prefs.putBool("landscape", landscape);
    applyOrientation();
    redraw = true;
  }
  lastButton = button;

  if (redraw) {
    drawAll();
  }

  delay(30);
}
