ZS6SR/TimeBuddy/(commit log)

2026-10-26 TimeBuddy: firmware, case and wiring
    [timebuddy_back.stl, timebuddy_frame.stl, timebuddy_stand.stl]
2026-10-26 MotoGP and F1 next race with venue, weekend dates, race forecast and track outline
